clrvyntx/i4a/docs/kicad/README.md

# Espressif KiCad Library
Download and install Espressif Library on KiCAD following the instructions in https://github.com/espressif/kicad-libraries

# Layout

## Node
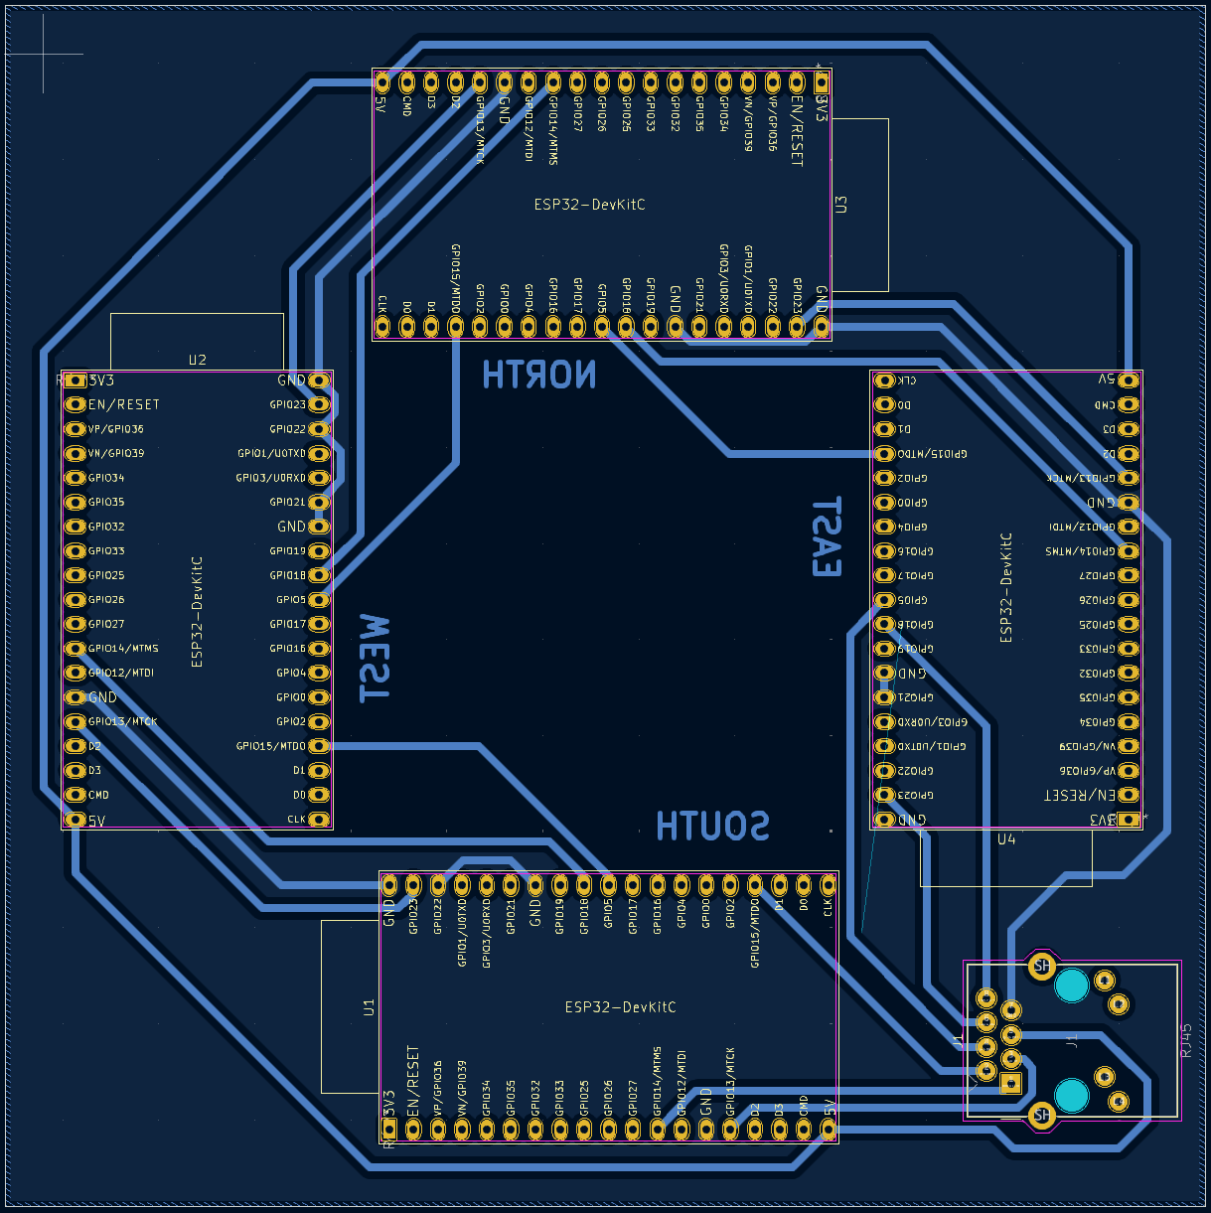
[picture p2: docs/kicad/node.png]
Node Layout


## Access Poimt
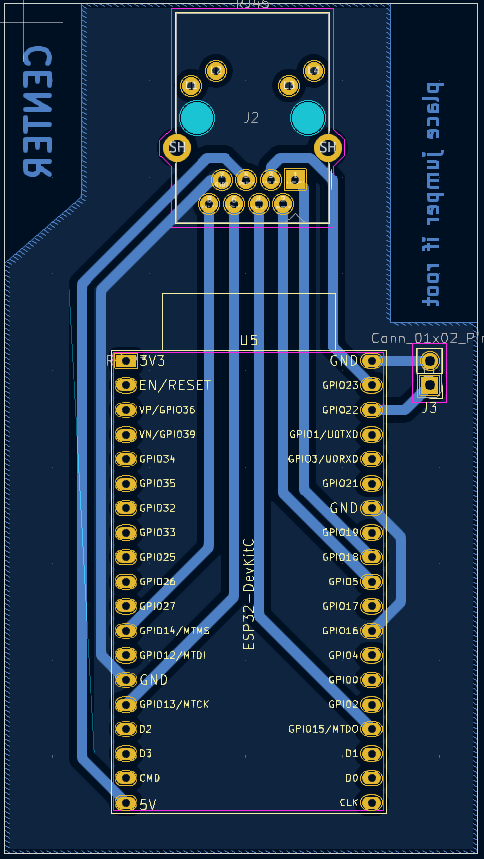
[picture p3: docs/kicad/access_point.png]
AP Layout
