clrvyntx/i4a/docs/arquitectura-conexiones-nodo.pdf

## Nodo_x

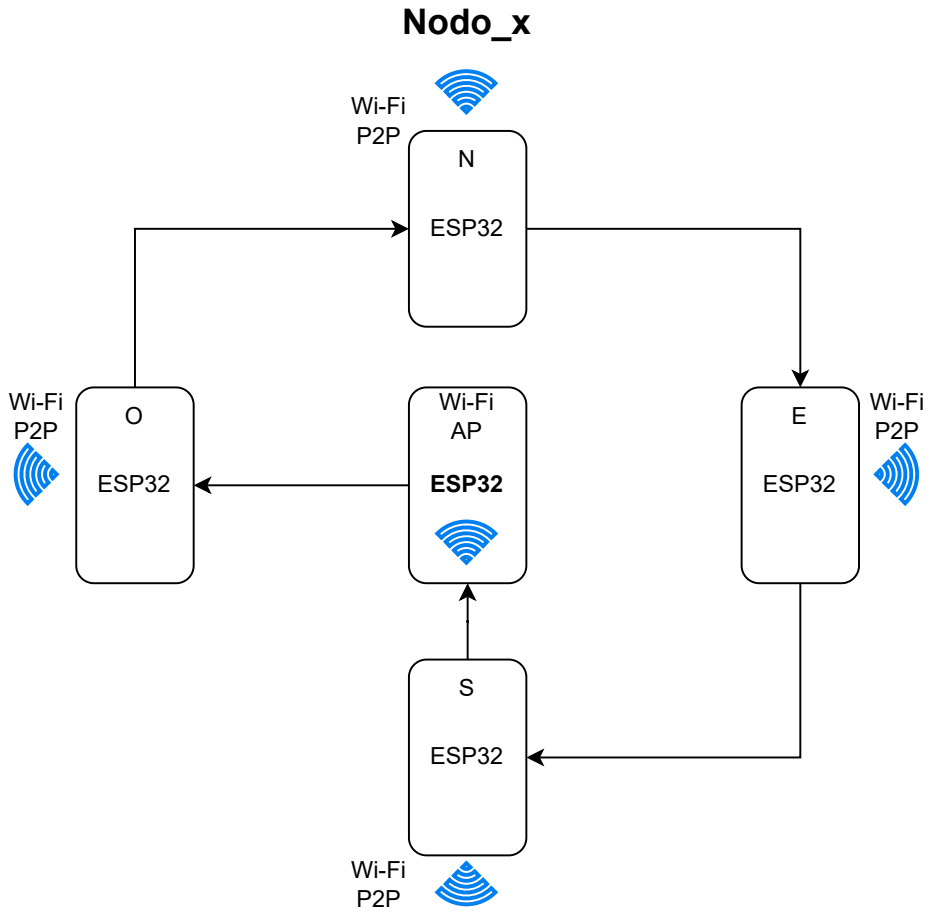
[picture p4: page 1]
ESP32
