clrvyntx/i4a/docs/kicad/node.kicad_pcb

## KiCad design docs/kicad/node.kicad_pcb (2025-05-14)

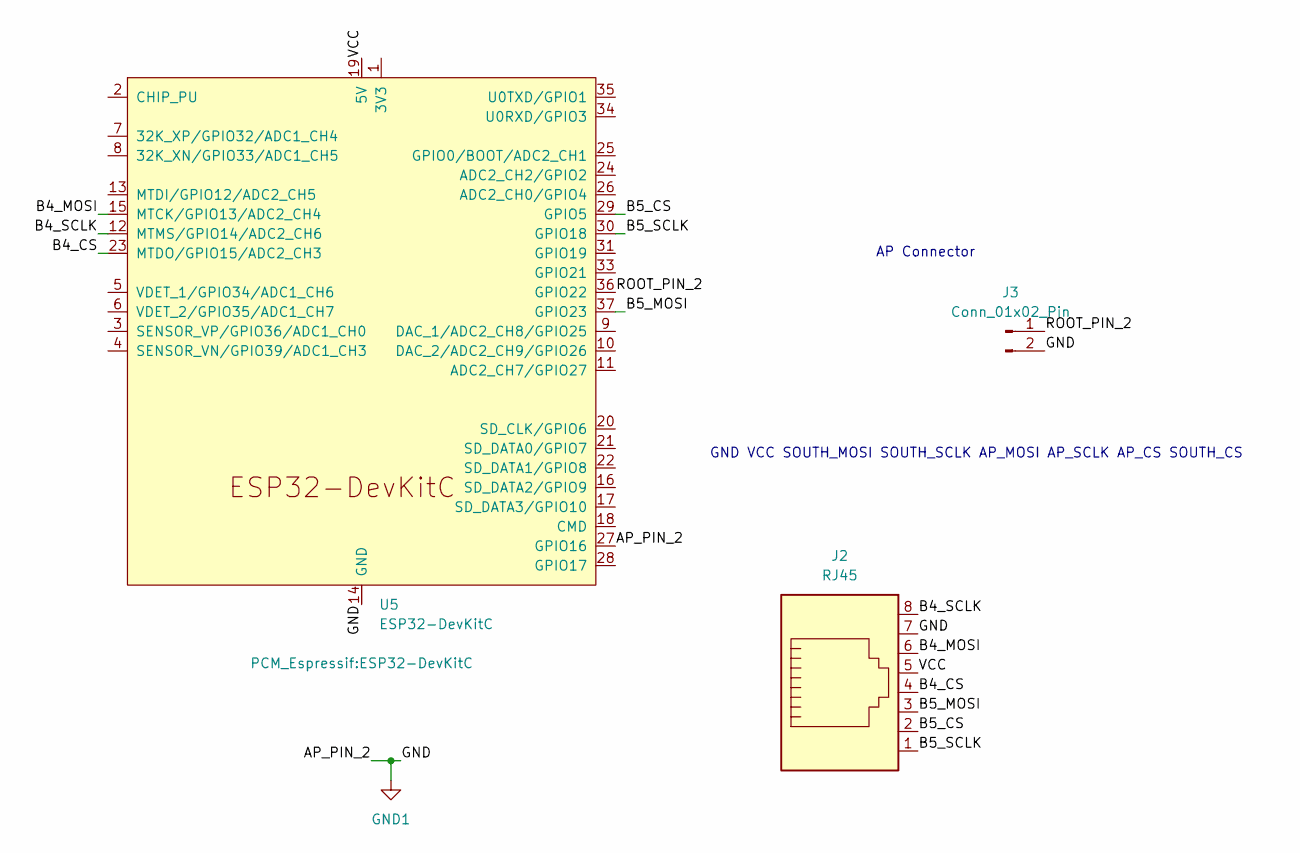
[picture p5: schematic ap.kicad_sch]

Parts:
J2: RJ45; RJ45_Amphenol_RJMG1BD3B8K1ANR
J3: Conn_01x02_Pin; PinHeader_1x02_P2.54mm_Vertical
U5: ESP32-DevKitC

Connections:
/ap/B4_CS: J2.4, U5.23 (MTDO/GPIO15/ADC2_CH3)
/ap/B4_MOSI: J2.6, U5.15 (MTCK/GPIO13/ADC2_CH4)
/ap/B4_SCLK: J2.8, U5.12 (MTMS/GPIO14/ADC2_CH6)
/ap/B5_CS: J2.2, U5.29 (GPIO5)
/ap/B5_MOSI: J2.3, U5.37 (GPIO23)
/ap/B5_SCLK: J2.1, U5.30 (GPIO18)
/ap/ROOT_PIN_2: J3.1, U5.36 (GPIO22)
/ap/VCC: J2.5, U5.19 (5V)
GND1: J2.7, J3.2, U5.14 (GND), U5.27 (GPIO16), U5.32 (GND), U5.38 (GND)

Notes on the sheet:
AP Connector
GND VCC SOUTH_MOSI SOUTH_SCLK AP_MOSI AP_SCLK AP_CS SOUTH_CS

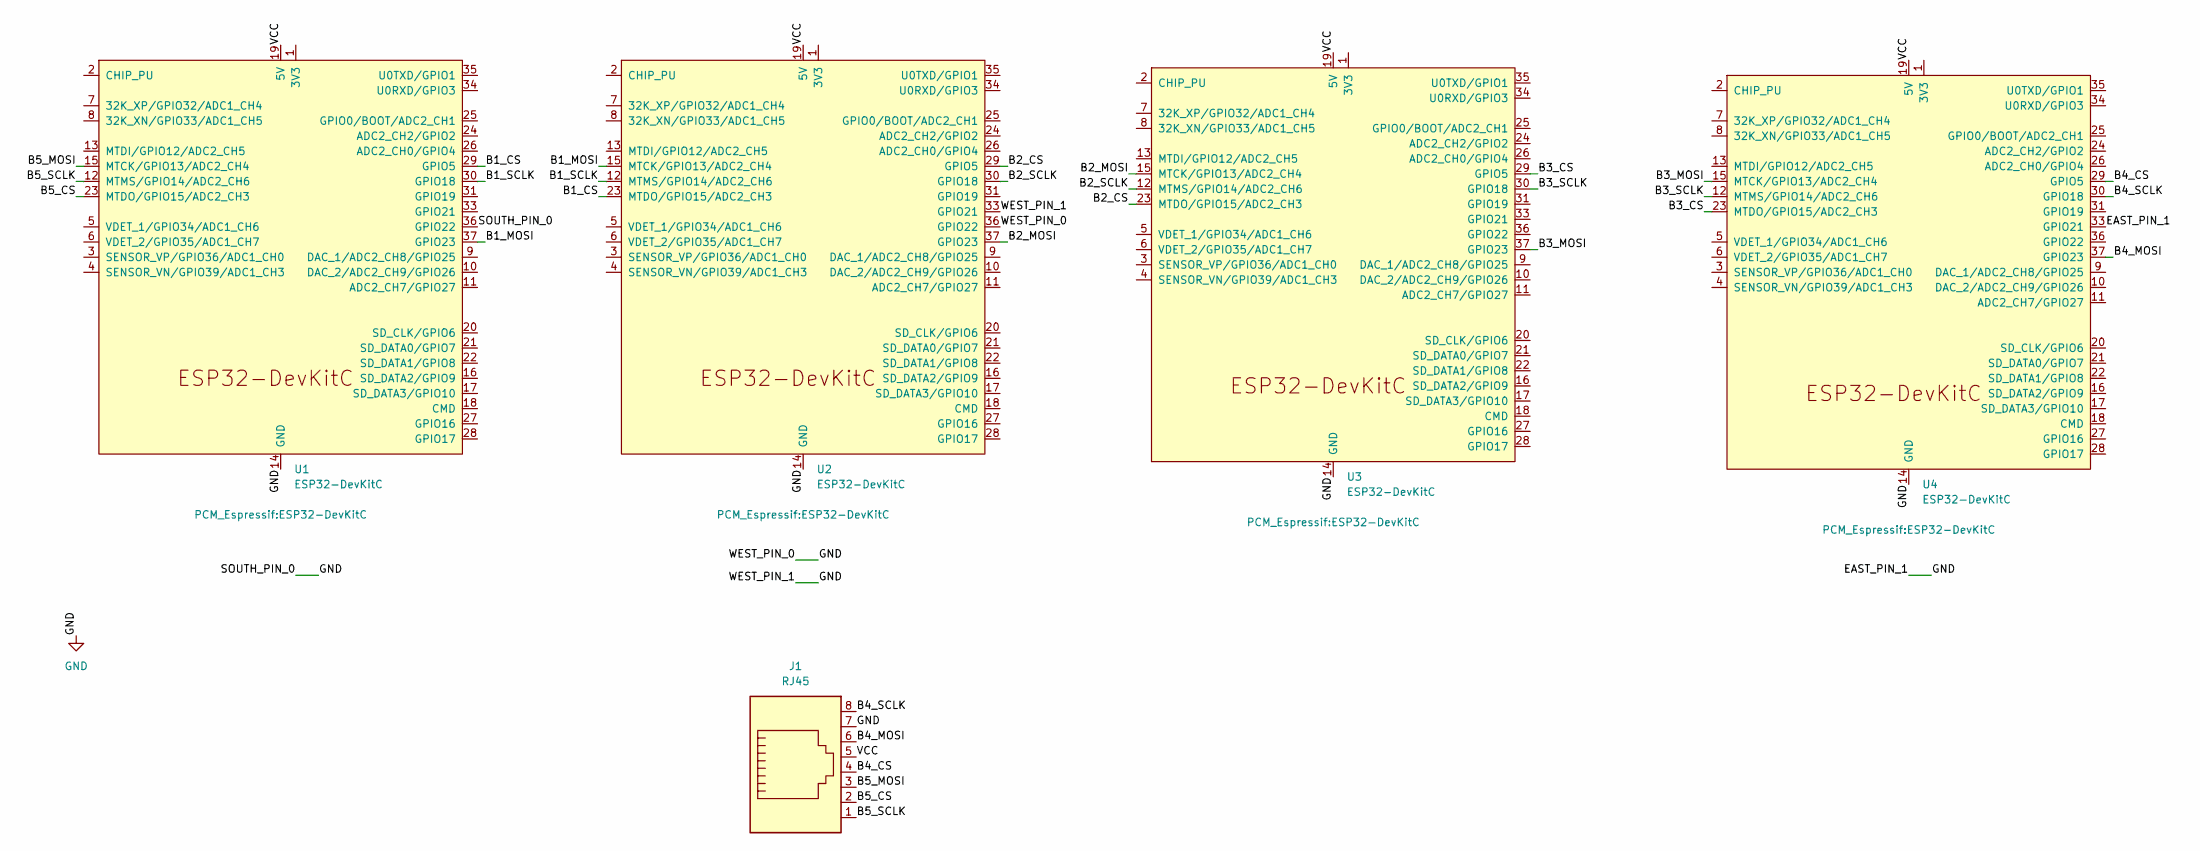
[picture p6: schematic main.kicad_sch]

Parts:
J1: RJ45; RJ45_Amphenol_RJMG1BD3B8K1ANR
U1, U2, U3, U4: ESP32-DevKitC

Connections:
/main/B1_CS: U1.29 (GPIO5), U2.23 (MTDO/GPIO15/ADC2_CH3)
/main/B1_MOSI: U1.37 (GPIO23), U2.15 (MTCK/GPIO13/ADC2_CH4)
/main/B1_SCLK: U1.30 (GPIO18), U2.12 (MTMS/GPIO14/ADC2_CH6)
/main/B2_CS: U2.29 (GPIO5), U3.23 (MTDO/GPIO15/ADC2_CH3)
/main/B2_MOSI: U2.37 (GPIO23), U3.15 (MTCK/GPIO13/ADC2_CH4)
/main/B2_SCLK: U2.30 (GPIO18), U3.12 (MTMS/GPIO14/ADC2_CH6)
/main/B3_CS: U3.29 (GPIO5), U4.23 (MTDO/GPIO15/ADC2_CH3)
/main/B3_MOSI: U3.37 (GPIO23), U4.15 (MTCK/GPIO13/ADC2_CH4)
/main/B3_SCLK: U3.30 (GPIO18), U4.12 (MTMS/GPIO14/ADC2_CH6)
/main/B4_CS: J1.4, U4.29 (GPIO5)
/main/B4_MOSI: J1.6, U4.37 (GPIO23)
/main/B4_SCLK: J1.8, U4.30 (GPIO18)
/main/B5_CS: J1.2, U1.23 (MTDO/GPIO15/ADC2_CH3)
/main/B5_MOSI: J1.3, U1.15 (MTCK/GPIO13/ADC2_CH4)
/main/B5_SCLK: J1.1, U1.12 (MTMS/GPIO14/ADC2_CH6)
/main/VCC: J1.5, U1.19 (5V), U2.19 (5V), U3.19 (5V), U4.19 (5V)
GND: J1.7, U1.14 (GND), U1.32 (GND), U1.36 (GPIO22), U1.38 (GND), U2.14 (GND), U2.32 (GND), U2.33 (GPIO21), U2.36 (GPIO22), U2.38 (GND), U3.14 (GND), U3.32 (GND), U3.38 (GND), U4.14 (GND), U4.32 (GND), U4.33 (GPIO21), U4.38 (GND)

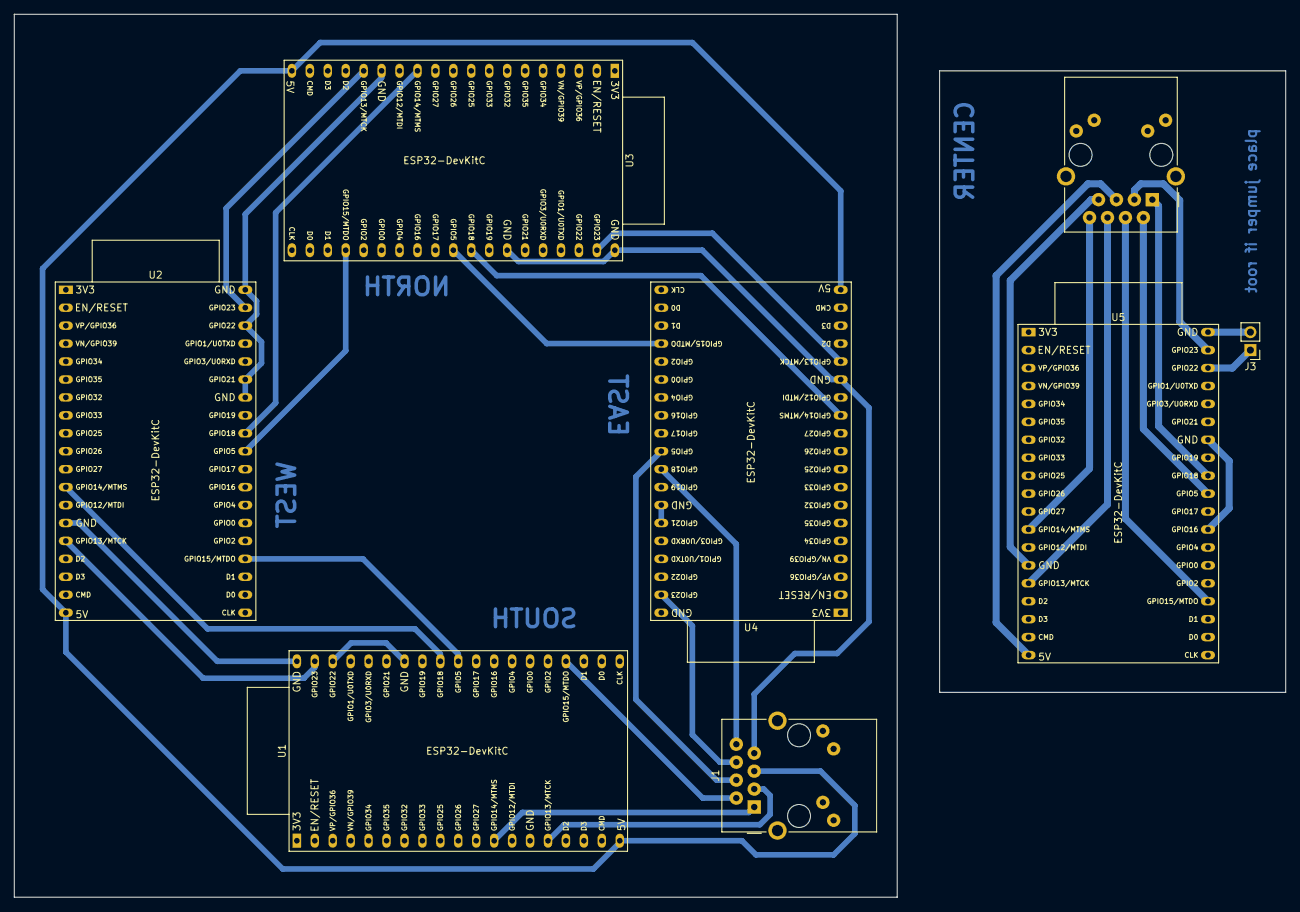
[picture p7: board node.kicad_pcb from above]

Board: 2 copper layers, 180.0 x 125.0 mm, 8 parts (0 on the bottom side), 26 nets.
