clrvyntx/i4a/components/integration/routing_hooks/routing_hooks.h

#ifndef _ROUTING_HOOKS_H_
#define _ROUTING_HOOKS_H_

#include <stdint.h> 
#include "esp_netif_net_stack.h"
#include "esp_netif.h"
#include "routing/routing.h"

typedef enum routing_hook_type {
    ROUTING_HOOK_ROOT_CENTER,
    ROUTING_HOOK_FORWARDER,
    ROUTING_HOOK_HOME,
    ROUTING_HOOK_WIFI_NETIF_DEFAULT,
    ROUTING_HOOK_CUSTOM,
    ROUTING_HOOK_COUNT
} routing_hook_type_t;

// Function pointer type for custom routing hooks
typedef struct netif *(*routing_hook_func_t)(uint32_t src_ip, uint32_t dst_ip);

void node_set_routing_hook(routing_hook_type_t hook);
void node_register_custom_routing_hook(routing_hook_func_t hook);
struct netif *node_do_routing(uint32_t src, uint32_t dst);
routing_t *node_get_rt_instance(void);
void node_print_routing_table(void);

#endif // _ROUTING_HOOKS_H_
