clrvyntx/i4a/components/internal/ring_link_lowlevel/include/ring_link_lowlevel_impl.h

#ifndef __RING_LINK_LOWLEVEL_IMPL_H
#define __RING_LINK_LOWLEVEL_IMPL_H

#ifdef CONFIG_RING_LINK_LOWLEVEL_IMPL_SPI
#include "spi.h"

#define RING_LINK_LOWLEVEL_BUFFER_SIZE          SPI_BUFFER_SIZE
#define RING_LINK_LOWLEVEL_IMPL_INIT            spi_init
#define RING_LINK_LOWLEVEL_IMPL_TRANSMIT        spi_transmit
#define RING_LINK_LOWLEVEL_IMPL_FREE_RX_BUFFER  spi_free_rx_buffer
#endif

#endif
